nimakolahi/lelo_vco_sky130a/README.md

GDS
DRC
LVS
DOCS
SIM

# Who
n.mahmoudi

# Why

The main target is to design a VCO cell to be used to measure internal voltages inside a SoC.

# How

The VCO core is a current-starving VCO design extracted from the papers in the state-of-the-art.

# What

| What | Cell/Name |
| :---- |  :----: |
| Schematic | design/LELO_VCO_SKY130A/LELO_VCO.sch |
| Layout | design/LELO_VCO_SKY130A/LELO_VCO.mag |

# Changelog/Plan

| Version | Status | Comment|
| :---| :---| :---|
|0.1.0 | :x: | Make something |

# Signal interface

| Signal | Direction | Domain  | Description |
| :--- | :---: | :---: | :--- |
| VDD_1V8 | Input | VDD_1V8 | Main supply |
| VSS | Input | Ground  | |
| PWRUP_1V8 | Input | VDD_1V8 | Power up the circuit |

# Key parameters

| Parameter | Min | Typ | Max | Unit  |
| :--- | :---: | :---: | :---: | :---: |
| Technology | | Skywater 130 nm | | |
| AVDD | 1.7 | 1.8 | 1.9 | V |
| Temperature | -40 | 27 | 125 | C |

# Characterization

Tuning curve (output frequency vs. control voltage). Typical K_VCO ≈ 75 MHz/V,
usable range ≈ 0.5–1.3 V, ~6 → 67 MHz. Details and PVT-corner spread in
[sim/VCO/TUNING.md](sim/VCO/TUNING.md).

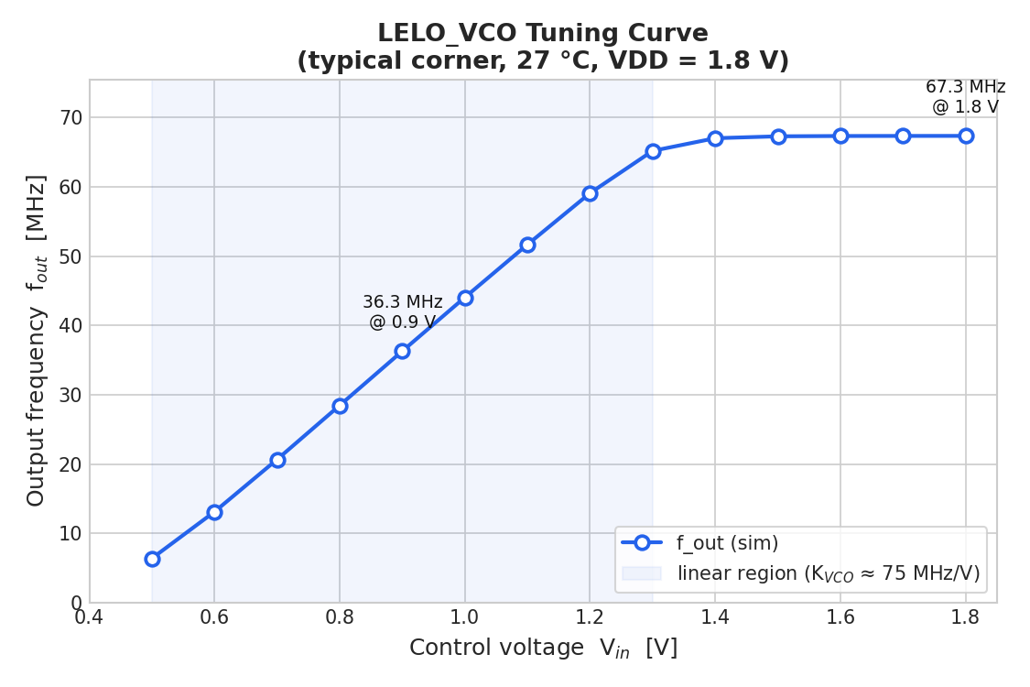
[picture p1: sim/VCO/vco_tuning_curve.png]
VCO tuning curve


# Read-out (frequency counter)

A synthesizable Verilog counter ([rtl/fcount.v](rtl/fcount.v)) counts VCO
cycles over a gate window to produce a digital code proportional to `f_out`
(hence to `Vin`) — the sensor read-out. The RTL is **co-simulated with the
analog VCO** in ngspice (mixed-signal `d_cosim`); see
[sim/FCOUNT/README.md](sim/FCOUNT/README.md). At Vin = 0.9 V it reads 581 counts
over a 16 µs window → 36.3 MHz.

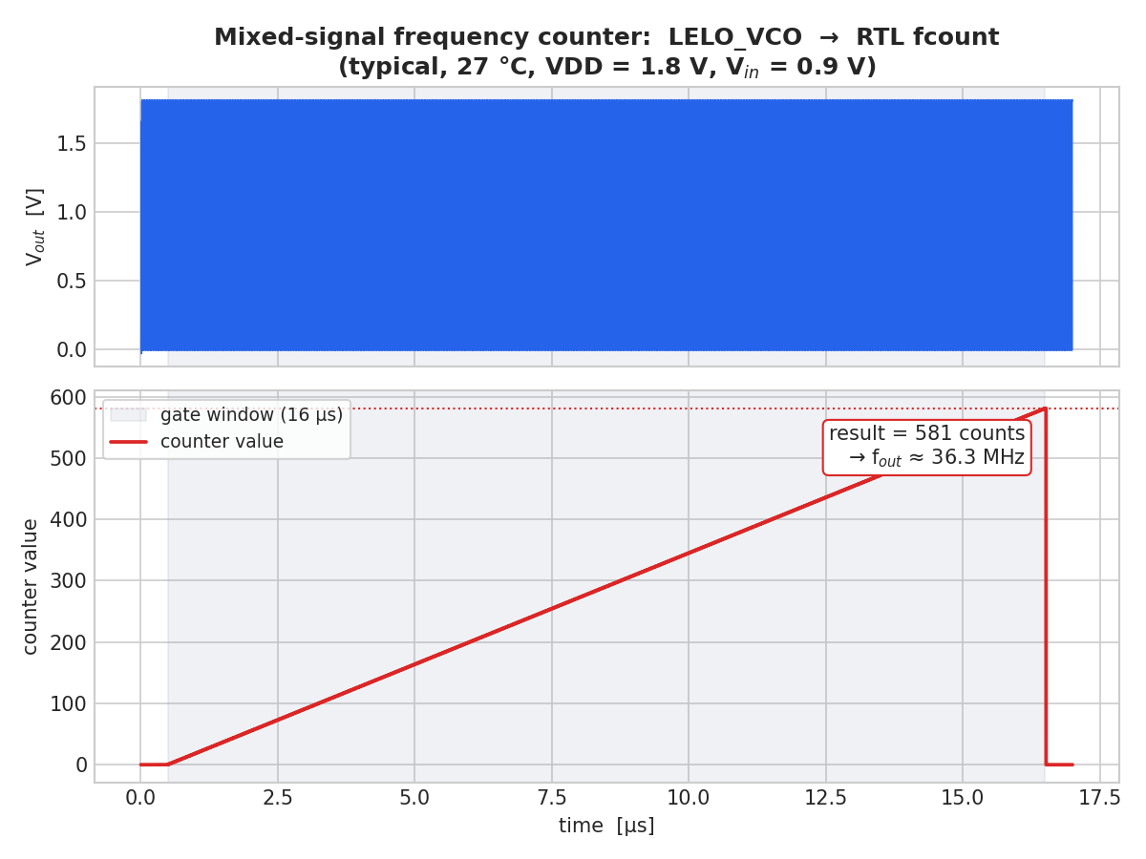
[picture p2: sim/FCOUNT/fcount_demo.png]
frequency counter demo
