nimakolahi/lelo_vco_sky130a/sim/VCO/vco_transient_typ.png

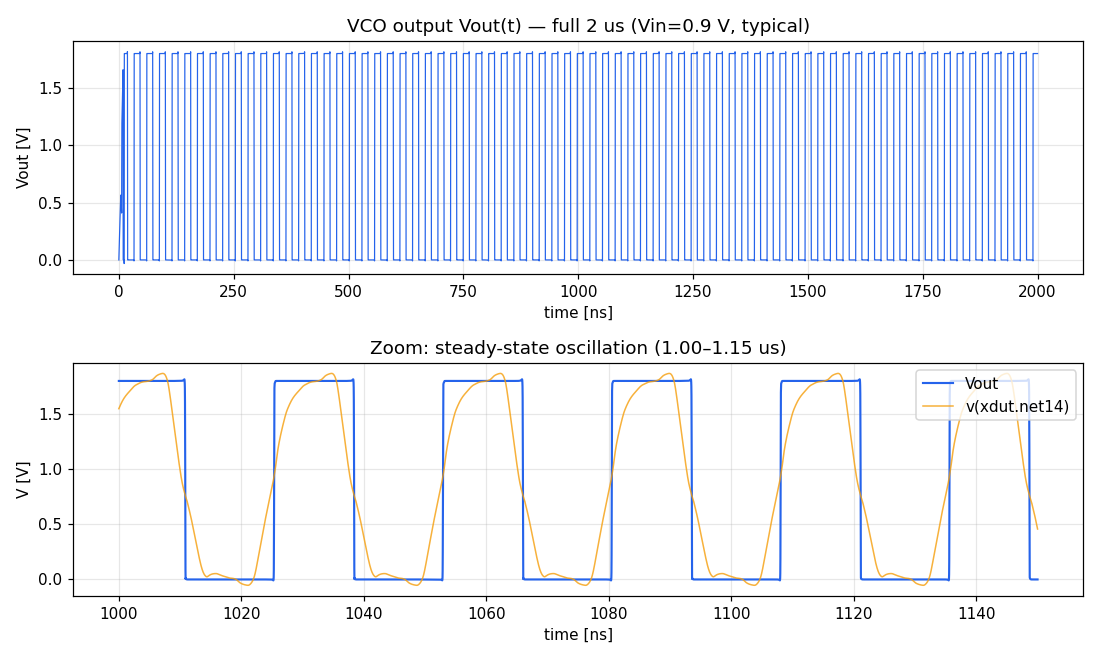
sim/VCO/vco_transient_typ.png
