nimakolahi/lelo_vco_sky130a/sim/VCO/results/tran_Lay_etc.md

### Summary tran_Lay_etc

For details see <a href='tran_Lay_etc.html'>tran_Lay_etc.html</a>

|**Name**|**Parameter**|**View**|**Min** | **Typ** | **Max**|
|:---|:---|:---:|:---:|:---:|:---:|
|Oscillation frequency|fosc | Spec | 20.0000 MHz | 50.0000 MHz | 120.0000 MHz |
| | | ('Lay',)|19.7756 MHz | 30.9440 MHz | 46.2869 MHz |
