nimakolahi/lelo_vco_sky130a/sim/VCO/results/tran_Lay_mc.md

### Summary tran_Lay_mc

For details see <a href='tran_Lay_mc.html'>tran_Lay_mc.html</a>

|**Name**|**Parameter**|**View**|**Min** | **Typ** | **Max**|
|:---|:---|:---:|:---:|:---:|:---:|
|Oscillation frequency|fosc | Spec | 20.0000 MHz | 50.0000 MHz | 120.0000 MHz |
| | | ('Lay',)|31.1777 MHz | 31.1777 MHz | 31.1777 MHz |
