nimakolahi/lelo_vco_sky130a/sim/VCO/results/tran_Lay_typical.md

### Summary tran_Lay_typical

For details see <a href='tran_Lay_typical.html'>tran_Lay_typical.html</a>

|**Name**|**Parameter**|**View**|**Min** | **Typ** | **Max**|
|:---|:---|:---:|:---:|:---:|:---:|
|Oscillation frequency|fosc | Spec | 20.0000 MHz | 50.0000 MHz | 120.0000 MHz |
| | | ('Lay',)|31.5438 MHz | 31.5438 MHz | 31.5438 MHz |
