nimakolahi/lelo_vco_sky130a/sim/VCO/results/tran_Sch_etc.md

### Summary tran_Sch_etc

For details see <a href='tran_Sch_etc.html'>tran_Sch_etc.html</a>

|**Name**|**Parameter**|**View**|**Min** | **Typ** | **Max**|
|:---|:---|:---:|:---:|:---:|:---:|
|Oscillation frequency|fosc | Spec | 20.0000 MHz | 50.0000 MHz | 120.0000 MHz |
| | | ('Sch',)|22.9261 MHz | 35.4883 MHz | 53.0473 MHz |
