nimakolahi/lelo_vco_sky130a/sim/VCO/results/tran_Sch_mc.md

### Summary tran_Sch_mc

For details see <a href='tran_Sch_mc.html'>tran_Sch_mc.html</a>

|**Name**|**Parameter**|**View**|**Min** | **Typ** | **Max**|
|:---|:---|:---:|:---:|:---:|:---:|
|Oscillation frequency|fosc | Spec | 20.0000 MHz | 50.0000 MHz | 120.0000 MHz |
| | | ('Sch',)|47.3699 MHz | 47.3699 MHz | 47.3699 MHz |
