nimakolahi/lelo_vco_sky130a/sim/VCO/results/tran_Lay_mc.csv

 | fosc | name | type | time | OK
0 | 31.177699999999998 | LayGtKttmmTtVt | Lay | Wed Sep 9 15:42:05 2026 | True
1 | 32.28059 | 1 |  | Wed Sep 9 15:42:14 2026 | True
2 | 32.73319 | 2 |  | Wed Sep 9 15:42:21 2026 | True
3 | 31.99382 | 3 |  | Wed Sep 9 15:42:29 2026 | True
4 | 33.359159999999996 | 4 |  | Wed Sep 9 15:42:36 2026 | True
5 | 30.02864 | 5 |  | Wed Sep 9 15:42:44 2026 | True
6 | 26.12448 | 6 |  | Wed Sep 9 15:42:52 2026 | True
7 | 32.98797 | 7 |  | Wed Sep 9 15:42:59 2026 | True
8 | 32.522819999999996 | 8 |  | Wed Sep 9 15:43:07 2026 | True
9 | 32.86759 | 9 |  | Wed Sep 9 15:43:14 2026 | True
10 | 31.19148 | 10 |  | Wed Sep 9 15:43:21 2026 | True
11 | 33.36147 | 11 |  | Wed Sep 9 15:43:28 2026 | True
12 | 25.696379999999998 | 12 |  | Wed Sep 9 15:43:35 2026 | True
13 | 36.01909 | 13 |  | Wed Sep 9 15:43:43 2026 | True
14 | 27.58521 | 14 |  | Wed Sep 9 15:43:50 2026 | True
15 | 27.51729 | 15 |  | Wed Sep 9 15:43:58 2026 | True
16 | 28.087619999999998 | 16 |  | Wed Sep 9 15:44:06 2026 | True
17 | 32.32535 | 17 |  | Wed Sep 9 15:44:13 2026 | True
18 | 28.95082 | 18 |  | Wed Sep 9 15:44:21 2026 | True
19 | 33.68646 | 19 |  | Wed Sep 9 15:44:29 2026 | True
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
