nimakolahi/lelo_vco_sky130a/sim/VCO/results/tran_Lay_typical.csv

 | fosc | name | type | time | OK
0 | 31.543809999999997 | LayGtKttTtVt | Lay | Wed Sep 9 15:33:25 2026 | True
