nimakolahi/lelo_vco_sky130a/sim/VCO/results/tran_Sch_typical.csv

 | fosc | name | type | time | OK
0 | 36.28136 | SchGtKttTtVt | Sch | Wed Sep 9 15:36:16 2026 | True
