nimakolahi/lelo_vco_sky130a/sim/VCO/vco_tuning_lay.png

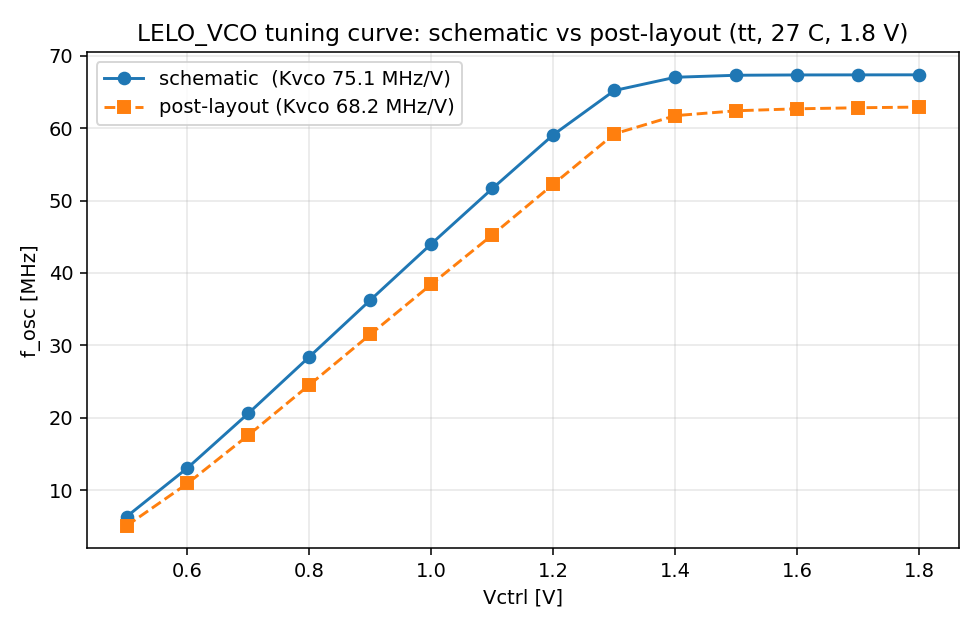
sim/VCO/vco_tuning_lay.png
