nimakolahi/lelo_vco_sky130a/(commit log)

2025-11-21 Made LELO_VCO_SKY130A
    [LELO_VCO.sch]
2025-11-21 Update setup
    [LELO_VCO.sch]
2026-07-06 Wire up current-starved VCO and add working transient sim
    - Fix schematic: tie all transistor bulks (NMOS->VSS, PMOS->VDD),
    connect current-mirror gate rails to the M25/M26 diode references
    - Reconcile sim scaffolding to cell LELO_VCO; drive Vin control input
    - Extend transient to 2us and measure oscillation frequency (fosc)
    - Result: robust oscillation, ~36 MHz typ (Vin=0.9V), 22.9-53 MHz across
    corners, 25.5-48 MHz Monte-Carlo 3-sigma; all within spec
    [LELO_VCO.sch, tran_Sch_etc.csv, tran_Sch_mc.csv, tran_Sch_typical.csv]
2026-07-08 layout: add 8 generated device cells; set XM27 nf=16 for multi-finger layout
    [LELO_VCO.sch]
2026-07-09 layout: add .sch/.sym library views for the 8 device cells (ATR pattern)
    [LELO_NCH_0p96x0p36.sch, LELO_NCH_1p2x0p18.sch, LELO_NCH_2p4x0p54.sch, LELO_NCH_96x0p9.sch, LELO_PCH_2p4x0p36.sch, LELO_PCH_4p8x0p18.sch, LELO_PCH_4p8x0p36.sch, LELO_PCH_4p8x0p54.sch]
2026-07-09 fix: regenerate XM27 as single-finger (nf=1) - multi-finger draw left fingers unconnected
    [LELO_NCH_96x0p9.sch]
2026-07-10 layout: regenerate device cells without guard rings (guard=0) for easier routing
2026-07-10 layout: hand-place devices with sane coords (cicpy wrote corrupt transforms -> segfault)
2026-07-10 fix: add FIXED_BBOX to device cells so cicpy places them (root cause of the segfault)
2026-07-13 sch: commit the library-cell swap (was only in working tree)
    [LELO_VCO.sch]
2026-07-13 layout: M27 as 10-finger device (gates tied; S/D to be strapped manually)
2026-07-13 layout: compact Fig.8-column placement (grouped cells, 10-finger M27, 0 DRC)
    [LELO_VCO.sch]
2026-07-14 layout: cicpy sch2mag place+route flow
    - Relabel device ports as flabel on locali (cicpy only reads flabel, not
    rlabel) so cicpy resolves D/G/S; add D/S/G flabels to 10-finger M27
    (S/D on locali, gate on metal1 rail).
    - Place via 'cicpy sch2mag --libdir ../design/ --techlib sky130' (trailing
    slash required for its glob), then respace.py adds vertical/horizontal
    gaps so the guard-less cells don't abut (nwell/li/diff spacing).
    - Remaining DRC is Metal1 min-area on unconnected S/D pads (clears when
    routed) plus intrinsic gencell artifacts; bulk B ties come with the
    outer guard ring added after routing.
2026-07-14 layout: paper-style band floorplan with shared nwell (Path B)
    Reproduce Fig.8 floorplan: rows bottom->top = NMOS current sources,
    ring NMOS, ring PMOS, PMOS current sources; M27+R1 bias block on the
    left. Paint ONE nwell strip over the two PMOS rows so every per-cell
    nwell merges into it (touching nwells are legally one well), which lets
    the guard-less cells pack tightly like the paper.
    Result ~36x20um (paper is 40.8x20.35). DRC clean except 102 Metal1
    min-area on unconnected S/D pads (clear on routing). Well/diff/overlap/
    abut spacing errors all eliminated.
    Note: DRC must load PDK tech via
    $PDK_ROOT/sky130A/libs.tech/magic/sky130A.magicrc; without it Magic
    falls back to minimum.tech and r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
2026-07-14 layout+sch: rename instances back to paper names M0-M27
    The group prefixes (a0-g3) only steered cicpy's placement grouping; the
    band floorplan doesn't need them. Renamed both schematic and layout
    instances to M0-M27 (resistors x1/x2). band_floorplan.py now emits the
    paper names directly via a grouped->M map. DRC unchanged (102 met1.6).
    [LELO_VCO.sch]
2026-07-27 layout: M27 finger strap, band-floorplan cells, DRC-clean; signal routing WIP
    - M27 (LELO_NCH_96x0p9): drains/sources strapped, extracts as one 96um device.
    - Shared-nwell band floorplan; nwell over M27 removed; DRC = 0.
    - Top-level power rails + port labels (VDD_1V8/VSS/Vin/Vout) placed.
    - Signal (ring/bias/VDD) routing still in progress: gate/bias nets
    currently collapse onto VSS in LVS; needs the per-net re-route.
2026-09-09 layout: move supply rails to metal2 so they stop shorting the cell gates
    Top level LVS was 16 nets against the schematic's 24, with 148 merge
    records in the extraction -- everything except a handful of local source
    nodes collapsed into one node, VDD_1V8 among them, so it did not even
    appear as a port.
    The leaf cells contact each gate at BOTH ends of the cell: metal1 frames
    at y +/-521..567, outside the D/S columns and hard against the cell
    edge, which is exactly where a horizontal rail runs. Five top level
    bars were drawn on metal1 along those edges and every one of them landed
    on the far-end gate frame of every cell it crossed:
    (4774,6673,10224,6831) the VDD strap -> gates of M15..M19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
2026-09-09 layout: finish the signal routing -- LVS now matches uniquely
    30 v 30 devices, 24 v 24 nets, "Circuits match uniquely", DRC OK.
    Everything here is one bug repeated: the leaf cells contact each gate at
    BOTH ends of the cell, in metal1 frames hard against the cell edge, and
    the rails run along those edges. Every rail picked up the gates of every
    cell it passed. The channel between the mirror row and the ring row is
    y 3302..3363; the old VSS rail was drawn 3301..3364, one unit into each
    row -- which is why every gate in the design sat on VSS.
    Shorts removed:
    * the VSS rail re-drawn inset, 3303..3362, and the VSS trunk extended
    from 3301 to 3310 to meet it;
    * six mirror stubs (M10..M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
2026-09-09 sim: post-layout results for LELO_VCO
    Now that LVS matches uniquely, the extracted netlist simulates. `make
    lpe` re-runs LVS on the parasitic netlist first and that also matches
    uniquely, so these numbers are against the laid-out circuit: 134
    parasitic caps, no extracted resistance.
    schematic post-layout
    fosc @ Vctrl 0.9 V 36.28 MHz 31.54 MHz -13.1 %
    Kvco (0.5..1.3 V) 75.1 MHz/V 68.2 MHz/V
    tuning range 6.4..67.3 5.1..62.9 MHz
    corners (16, etc) 22.9..53.0 19.8..46.3 MHz
    Monte Carlo (30) 25.5..48.0 3sd 20.8..41.8 3sd
    The ring slows about 13 % once its own wiring is loaded, which is the
    shape you expect: the parasitics are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
    [tran_Lay_etc.csv, tran_Lay_mc.csv, tran_Lay_typical.csv, tran_Sch_etc.csv, tran_Sch_typical.csv]
2026-09-10 sim: post-layout digital transfer curve for the VCO + counter
    The FCOUNT transfer curve was measured against the schematic netlist back
    in July. Now that the layout is LVS-clean and the extracted netlist
    itself matches uniquely, the same sweep runs against the parasitics.
    sensitivity 0.5..1.3 V 1201 c/V 1072 c/V -10.8 %
    code @ Vin 0.9 V 581 505 -13.1 %
    full scale 1080 961 -11.0 %
    The counter code IS the sensor output, so this is not a second-order
    effect: a read-out calibrated on schematic numbers reads about 11 % high.
    The curve keeps its shape -- linear region stil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
